reusable-rocketry-at-purdue/AtlasHardware/lowerBoard.kicad_pcb

## KiCad design lowerBoard.kicad_pcb (2020-03-28)

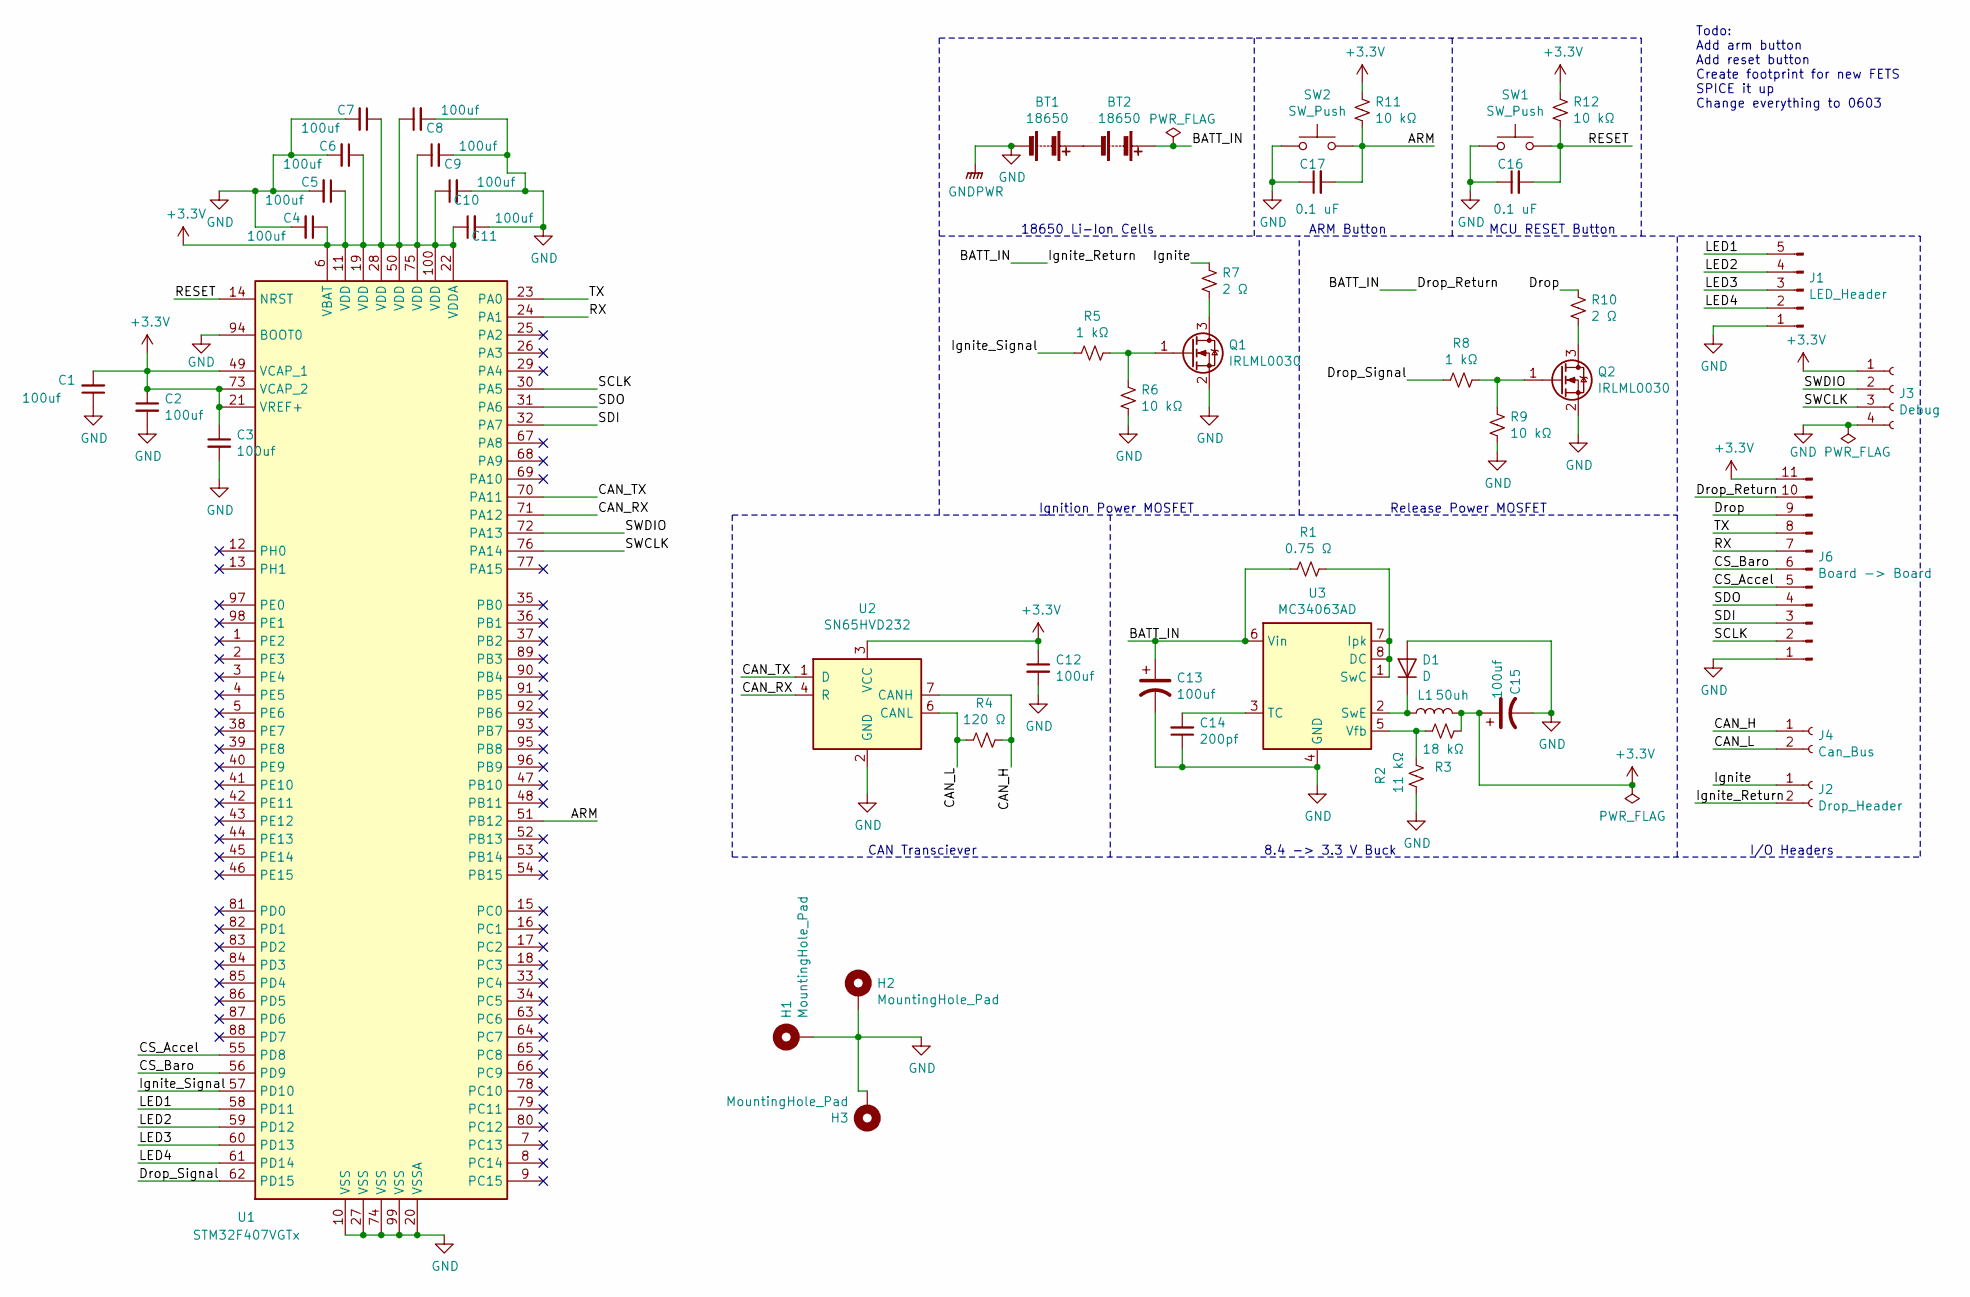
[picture p1: schematic lowerBoard.sch, Atlas Lower Board]

Parts:
BT1, BT2: 18650; BatteryHolder_MPD_BH-18650-PC2
C1, C2, C3, C4, C5, C6, C7, C8, C9, C10, C11, C12, C13, C15: 100uf; C_0603_1608Metric
C14: 200pf; C_0603_1608Metric
C16, C17: 0.1 uF; C_0603_1608Metric
D1: D; D_0603_1608Metric
H1, H2, H3: MountingHole_Pad; MountingHole_3mm_Pad_Via
J1: LED_Header; Molex_KK-254_AE-6410-05A_1x05_P2.54mm_Vertical
J2: Drop_Header; Molex_KK-254_AE-6410-02A_1x02_P2.54mm_Vertical
J3: Debug; Molex_KK-254_AE-6410-04A_1x04_P2.54mm_Vertical
J4: Can_Bus; Molex_KK-254_AE-6410-02A_1x02_P2.54mm_Vertical
J6: Board -> Board; Molex_KK-254_AE-6410-11A_1x11_P2.54mm_Vertical
L1: 50uh; C_0603_1608Metric
Q1, Q2: IRLML0030; SOT-23
R1: 0.75 Ω; R_0603_1608Metric
R2: 11 kΩ; R_0603_1608Metric
R3: 18 kΩ; R_0603_1608Metric
R4: 120 Ω; R_0603_1608Metric
R5, R8: 1 kΩ; R_0603_1608Metric
R6, R9, R11, R12: 10 kΩ; R_0603_1608Metric
R7, R10: 2 Ω; R_0603_1608Metric
SW1, SW2: SW_Push; SW_SPST_B3S-1000
U1: STM32F407VGTx; LQFP-100_14x14mm_P0.5mm
U2: SN65HVD232; SOIC-8_3.9x4.9mm_P1.27mm
U3: MC34063AD; SOIC-8_3.9x4.9mm_P1.27mm

Connections:
+3V3: C1.2, C2.1, C3.1, C4.1, C5.1, C6.1, C7.1, C8.1, C9.1, C10.1, C11.1, C12.1, C15.1, J3.1, J6.11, L1.2, R3.1, R11.1, R12.1, U1.6 (VBAT), U1.11 (VDD), U1.19 (VDD), U1.21 (VREF+), U1.22 (VDDA), U1.28 (VDD), U1.49 (VCAP_1), U1.50 (VDD), U1.73 (VCAP_2), U1.75 (VDD), U1.100 (VDD), U2.3 (VCC)
/ARM: C17.2, R11.2, SW2.2, U1.51 (PB12)
/BATT_IN: BT2.1 (+), C13.1, J2.2, J6.10, R1.2, U3.6 (Vin)
/CAN_H: J4.1, R4.1, U2.7 (CANH)
/CAN_L: J4.2, R4.2, U2.6 (CANL)
/CAN_RX: U1.71 (PA12), U2.4 (R)
/CAN_TX: U1.70 (PA11), U2.1 (D)
/CS_Accel: J6.5, U1.55 (PD8)
/CS_Baro: J6.6, U1.56 (PD9)
/Drop: J6.9, R10.1
/Drop_Signal: R8.2, U1.62 (PD15)
/Ignite: J2.1, R7.1
/Ignite_Signal: R5.2, U1.57 (PD10)
/LED1: J1.5, U1.58 (PD11)
/LED2: J1.4, U1.59 (PD12)
/LED3: J1.3, U1.60 (PD13)
/LED4: J1.2, U1.61 (PD14)
/RESET: C16.2, R12.2, SW1.2, U1.14 (NRST)
/RX: J6.7, U1.24 (PA1)
/SCLK: J6.2, U1.30 (PA5)
/SDI: J6.3, U1.32 (PA7)
/SDO: J6.4, U1.31 (PA6)
/SWCLK: J3.3, U1.76 (PA14)
/SWDIO: J3.2, U1.72 (PA13)
/TX: J6.8, U1.23 (PA0)
GND: BT1.2 (-), C1.1, C2.2, C3.2, C4.2, C5.2, C6.2, C7.2, C8.2, C9.2, C10.2, C11.2, C12.2, C13.2, C14.1, C15.2, C16.1, C17.1, D1.2 (A), H1.1, H2.1, H3.1, J1.1, J3.4, J6.1, Q1.2 (S), Q2.2 (S), R2.2, R6.1, R9.1, SW1.1, SW2.1, U1.10 (VSS), U1.20 (VSSA), U1.27 (VSS), U1.74 (VSS), U1.94 (BOOT0), U1.99 (VSS), U2.2 (GND), U3.4 (GND)
unnamed: BT1.1 (+), BT2.2 (-)
unnamed: C14.2, U3.3 (TC)
unnamed: D1.1 (K), L1.1, U3.2 (SwE)
unnamed: Q1.1 (G), R5.1, R6.2
unnamed: Q1.3 (D), R7.2
unnamed: Q2.1 (G), R8.1, R9.2
unnamed: Q2.3 (D), R10.2
unnamed: R1.1, U3.1 (SwC), U3.7 (Ipk), U3.8 (DC)
unnamed: R2.1, R3.2, U3.5 (Vfb)

Notes on the sheet:
18650 Li-Ion Cells
ARM Button
MCU RESET Button
Ignition Power MOSFET
Release Power MOSFET
I/O Headers
8.4 -> 3.3 V Buck
CAN Transciever
Todo: Add arm button Add reset button Create footprint for new FETS SPICE it up Change everything to 0603

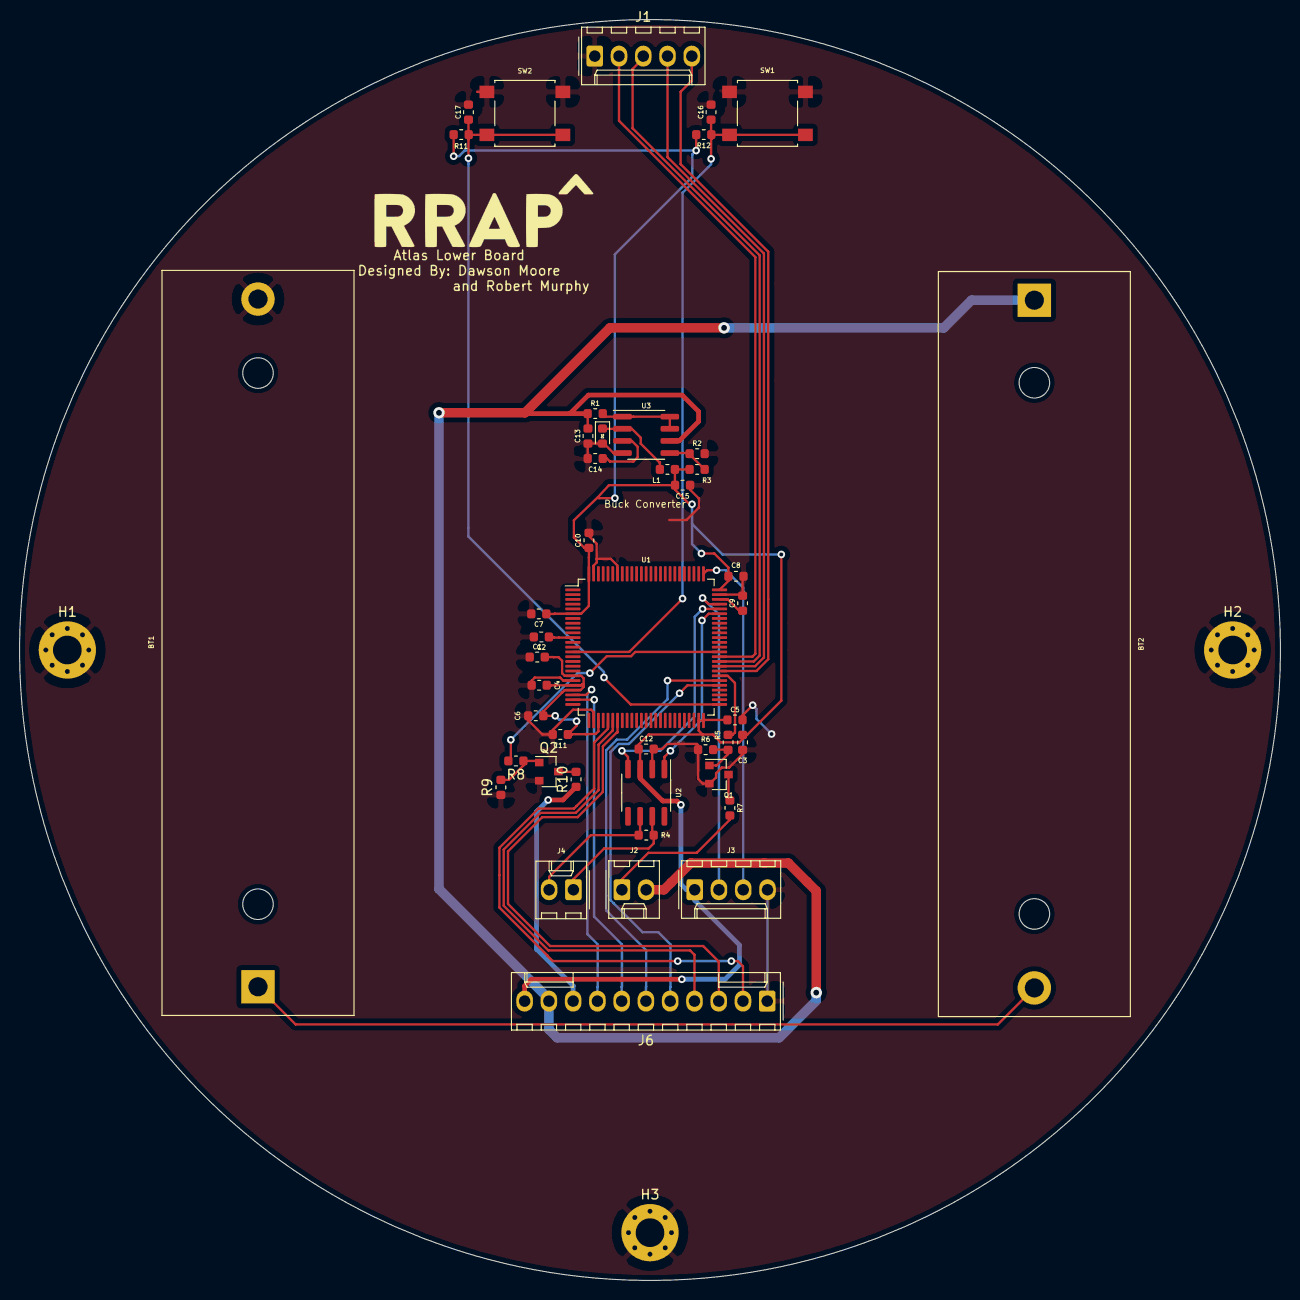
[picture p2: board lowerBoard.kicad_pcb from above]

Board: 2 copper layers, 132.0 x 132.0 mm, 48 parts (0 on the bottom side), 35 nets.
