reusable-rocketry-at-purdue/AtlasHardware/(threads)

Thread 1 (2020-02-26):

Make new header for LED board

DMoore12, 2020-02-26:
The current LED board will take 5 pins. The extra pin is ground. Currently, the circuit will not be completed since none of the LEDs are grounded.

- [x] Delete old 4 pin and add a new 5 pin
- [x] Add GND to new header
- [x] Re-route header and use GND fill to ground last pad

Closed 2020-03-03.

Thread 2 (2020-02-26):

Change orientation of decoupling capacitors on STM32

DMoore12, 2020-02-26:
Currently, the decoupling capacitors are normal to the pins on the micro. This means there isn't enough room to route +3.3 V, as well as some signals. Changing the caps to be parallel with the pins will help.

- [x] Change orientation of caps
- [x] Re-route +3V3 pins
- [x] Ground caps with polygon fill

Closed 2020-03-03.

Thread 3 (2020-02-26):

Change MOSFET topology

DMoore12, 2020-02-26:
Currently, the MOSFET topology has the battery voltage on the drain with current limiting resistors heading out of the source to the ignite and release FETs. However, this  won't work since the gate to source voltage will modulate due to the source resistance (I'm dumb). Therefore, the current limiting resistance needs to be connected where BATT_IN is, and the IGNITE, line should be ground. Then, the battery voltage needs to go to the nichrome wires. I'll send a picture of the topology. Essentially, the FETs need to be slightly rerouted (the pulldown system is staying the same) and the headers that go to the ignition system and release mechanism need to have another pin since the return for the current we send to them is no longer routed back by ground (you'll see this in the topology I send you).

- [x] Change drain and source configuration to match new topology
- [x] Add pins to new headers
- [x] Re-route FETs
- [x] Re-route headers

Closed 2020-03-03.
