reusable-rocketry-at-purdue/AtlasHardware/(commit log)

2020-02-17 Add routed upper board files
    [upperBoard.kicad_pcb, upperBoard.sch]
2020-02-25 Gerber file for upper board
